kohlerz/SnowMelt/PCBs/mega/mega_pcb.png

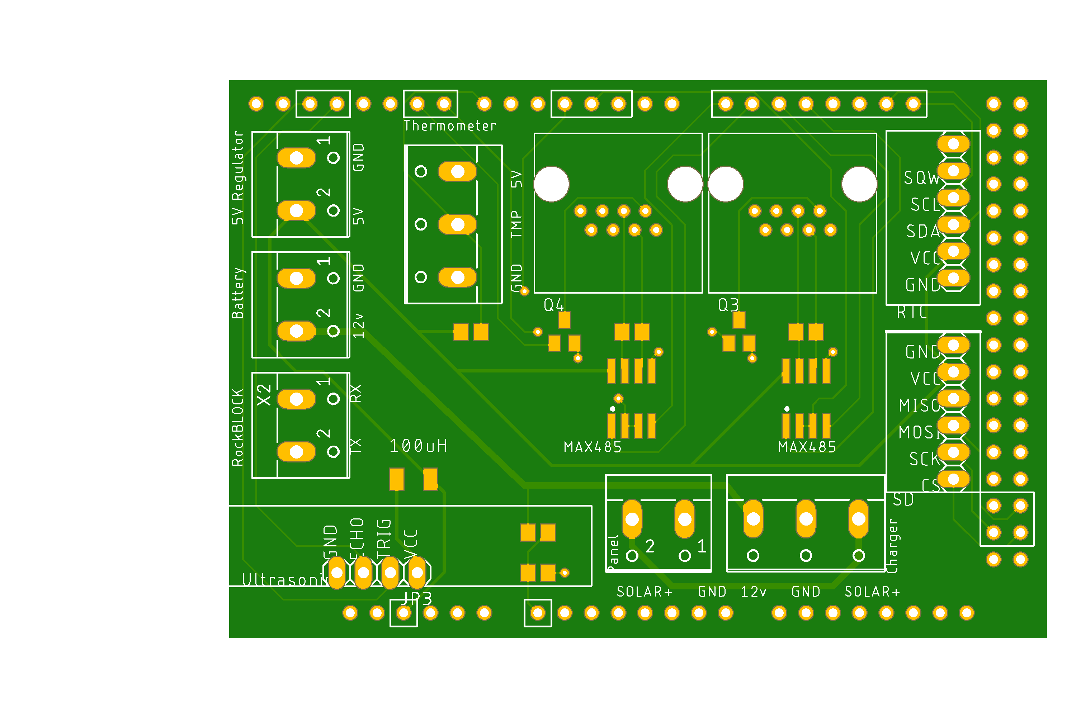
PCBs/mega/mega_pcb.png
