kohlerz/SnowMelt/PCBs/scale/scale_pcb.png

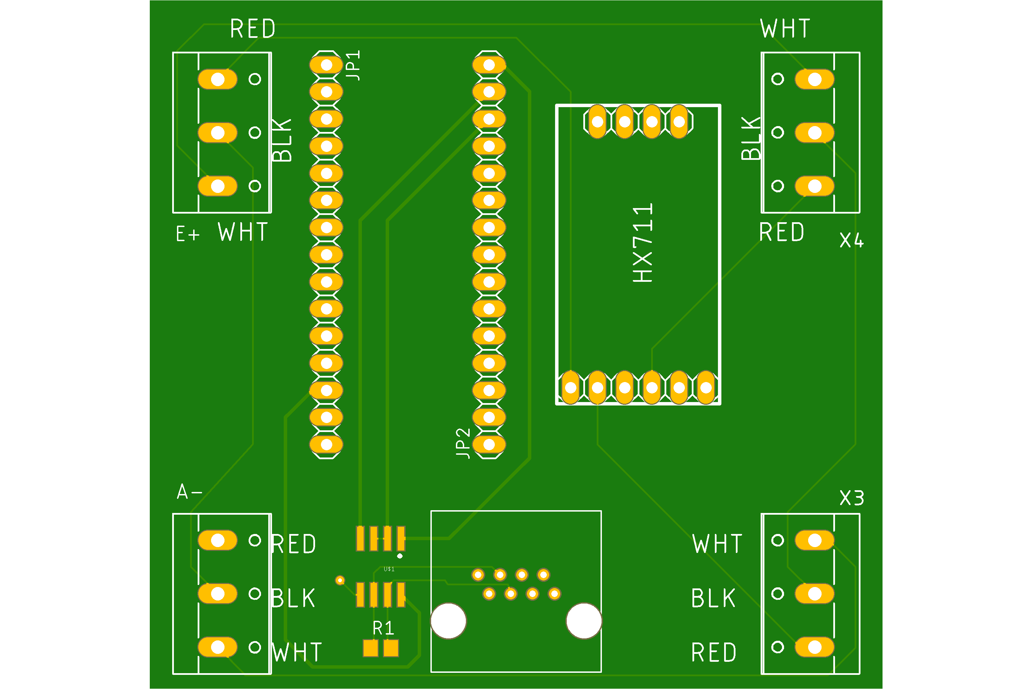
PCBs/scale/scale_pcb.png
