kohlerz/SnowMelt/src/WiFi Mega DIP Settings.jpg

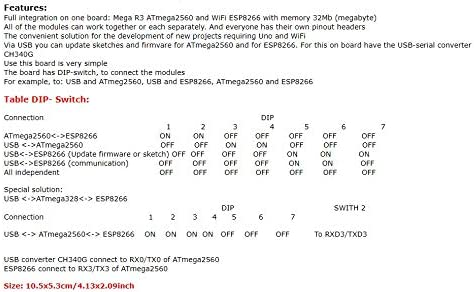
src/WiFi Mega DIP Settings.jpg
