kohlerz/SnowMelt/3D Printing Files/ScaleBottom.stl

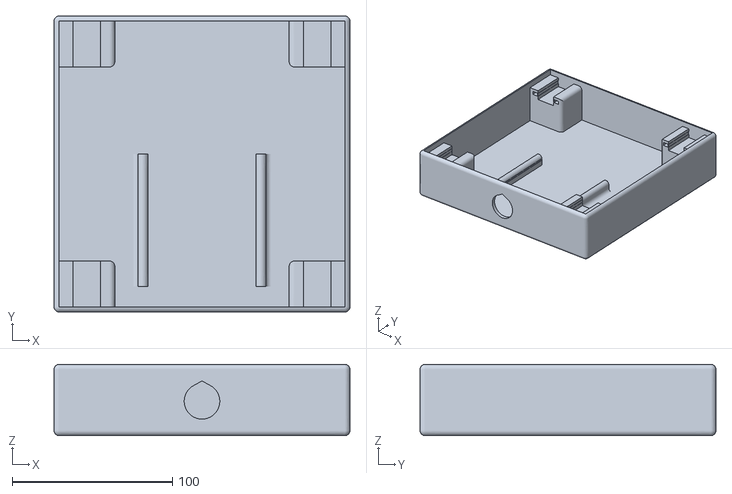
[picture p4: CAD file, 2021-11-07]
3D Printing Files/ScaleBottom.stl
184.8 x 184.8 x 44.4
