kohlerz/SnowMelt/3D Printing Files/ScaleTop.stl

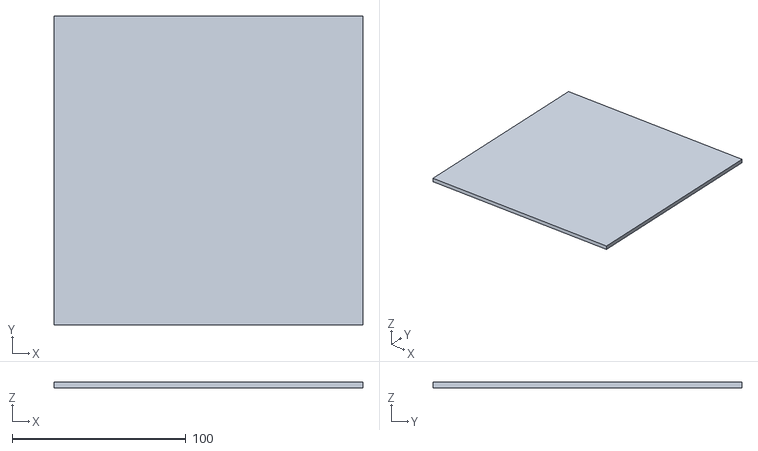
[picture p5: CAD file, 2021-11-07]
3D Printing Files/ScaleTop.stl
177.8 x 177.8 x 3.17
