kohlerz/SnowMelt/PCBs/mega/mega_schematic.pdf

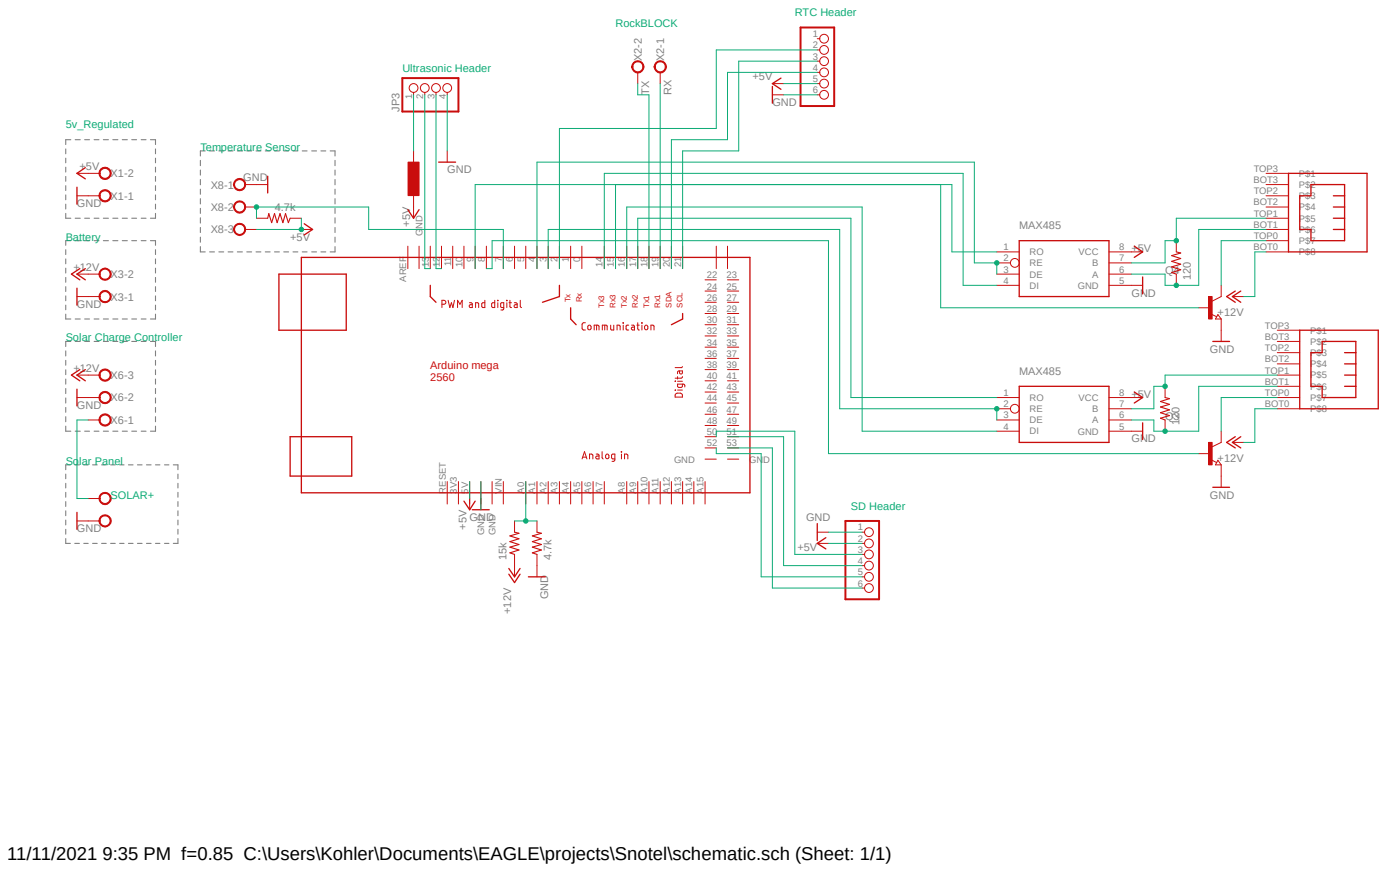
[picture p6: page 1]
MAX485 MAX485; +5V GND; GND; GND GND GND GND +5V; +12V GND; 7 VCC; 8 AREF GND 131211109; 23 25 27 29 31 33 35 37 39 41 43 45 47 49 51 53 GND; 52 GND VIN; A⁰A¹A²A³A⁴A⁵A⁶A⁷; A⁸A⁹A¹⁰ A¹¹ A¹² A¹³ A¹⁴ A¹⁵ GND GND RESET 3V³ 5V; P$1 TOP3; P$2 BOT3; P$3 TOP2; P$4 BOT2; P$5 TOP1; P$6 BOT1; P$7 TOP0; P$8 BOT0; P$8 BOT0 X²⁻²; X²⁻¹ TxRx; Tx3 Rx3 Tx2 Rx2 Tx1 Rx1 SDA SCL; Arduino mega 2560 SOLAR+; 5v_Regulated; Battery; RockBLOCK; Temperature Sensor; Ultrasonic Header; RTC Header; SD Header

Solar Charge Controller Solar Panel
+12V GND GND

11/11/2021 9:35 PM f=0.85 C:\Users\Kohler\Documents\EAGLE\projects\Snotel\schematic.sch (Sheet: 1/1)
