kohlerz/SnowMelt/PCBs/scale/scale_schematic.pdf

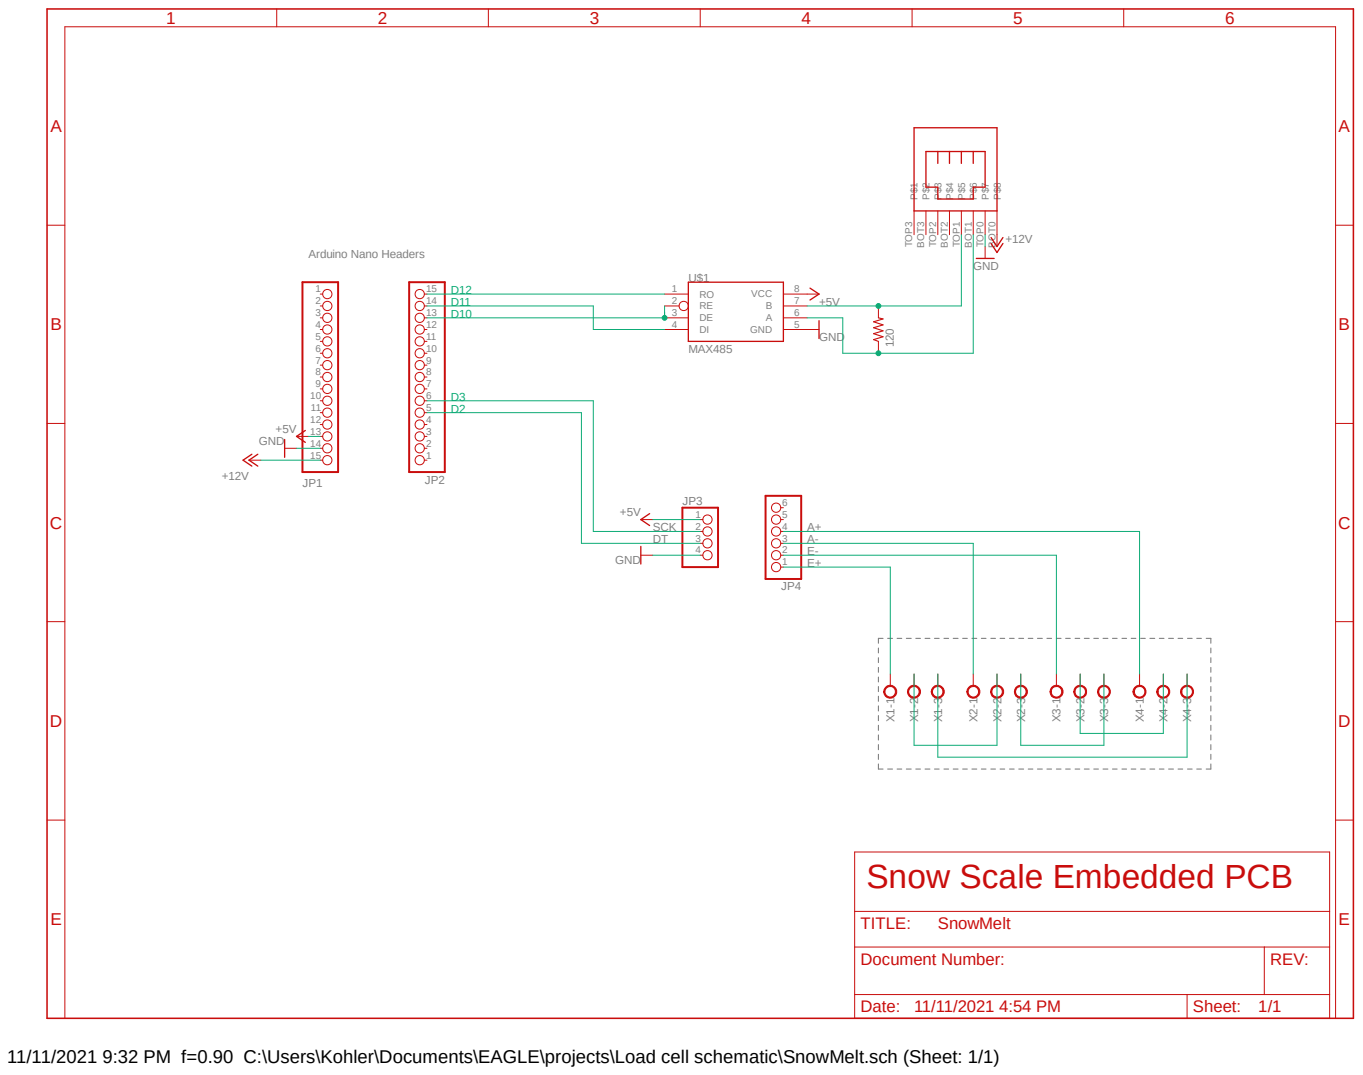
[picture p7: page 1]

Snow Scale Embedded PCB

Document Number: | REV:

Date: 11/11/2021 4:54 PM | Sheet: 1/1

11/11/2021 9:32 PM f=0.90 C:\Users\Kohler\Documents\EAGLE\projects\Load cell schematic\SnowMelt.sch (Sheet: 1/1)
