kohlerz/SnowMelt/PCBs/mega/mega.brd

## EAGLE design PCBs/mega/mega.brd (2021-11-12)

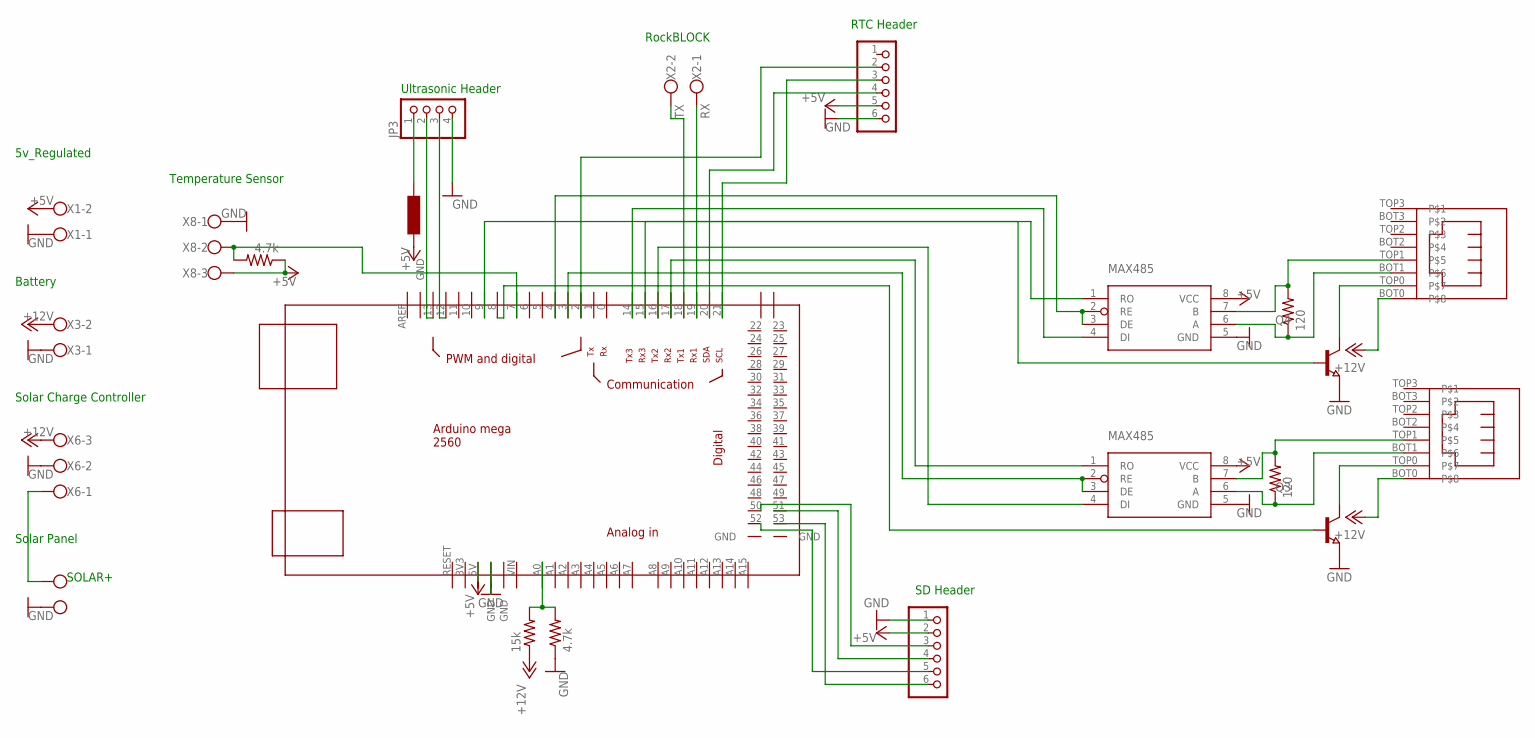
[picture p8: schematic mega.sch]

Parts:
JP1, JP2: PINHD-1X6; 1X06
JP3: PINHD-1X4; 1X04
JP4, JP5: ETHERNET
L1: 100uH; NLFV32T-101K-EF
Q3, Q4: NPN-TRANSISTOR_SOT23; SOT23
R1, R7: 120; R0805
R3, R9: 4.7k; R0805
R8: 15k; R0805
U$1, U$2: MAX485; SO08
U$3: MEGA_DEVICE; MEGAOUTLINE
X1, X2, X3, X7: W237-102
X6, X8: W237-103

Connections:
+5V: JP1.2, JP2.5, L1.P$1, R3.1, U$1.8 (VCC), U$2.8 (VCC), U$3.5V, X1.2, X8.3
+12V: JP4.BOT0, JP5.BOT0, R8.1, X3.2, X6.3
GND: JP1.1, JP2.6, JP3.4, Q3.2 (E), Q4.2 (E), R9.1, U$1.5 (GND), U$2.5 (GND), U$3.GND@2 (GND), X1.1, X3.1, X6.2, X7.1, X8.1
unnamed: JP4.TOP1, R1.2, U$1.7 (B)
unnamed: JP4.BOT1, R1.1, U$1.6 (A)
unnamed: JP5.TOP1, R7.2, U$2.7 (B)
unnamed: JP5.BOT1, R7.1, U$2.6 (A)
unnamed: U$2.1 (RO), U$3.17
unnamed: U$2.4 (DI), U$3.16
unnamed: U$1.1 (RO), U$3.15
unnamed: U$1.4 (DI), U$3.14
unnamed: JP2.2, U$3.2
unnamed: U$2.2 (RE), U$2.3 (DE), U$3.3
unnamed: U$1.2 (RE), U$1.3 (DE), U$3.4
unnamed: JP2.3, U$3.21
unnamed: JP2.4, U$3.20
unnamed: JP1.6, U$3.53
unnamed: JP1.5, U$3.52
unnamed: JP1.4, U$3.51
unnamed: JP1.3, U$3.50
unnamed: JP3.2, U$3.13
unnamed: JP3.3, U$3.12
unnamed: Q3.1 (B), U$3.8
unnamed: JP4.TOP0, Q4.3 (C)
unnamed: JP5.TOP0, Q3.3 (C)
unnamed: Q4.1 (B), U$3.9
unnamed: JP3.1, L1.P$2
unnamed: R8.2, R9.2, U$3.A0
unnamed: X6.1, X7.2
unnamed: R3.2, U$3.7, X8.2
RX: U$3.19, X2.1
TX: U$3.18, X2.2

Notes on the sheet:
SOLAR+
5v_Regulated
Battery
Solar Charge Controller
Solar Panel
RockBLOCK
Temperature Sensor
Ultrasonic Header
RTC Header
SD Header

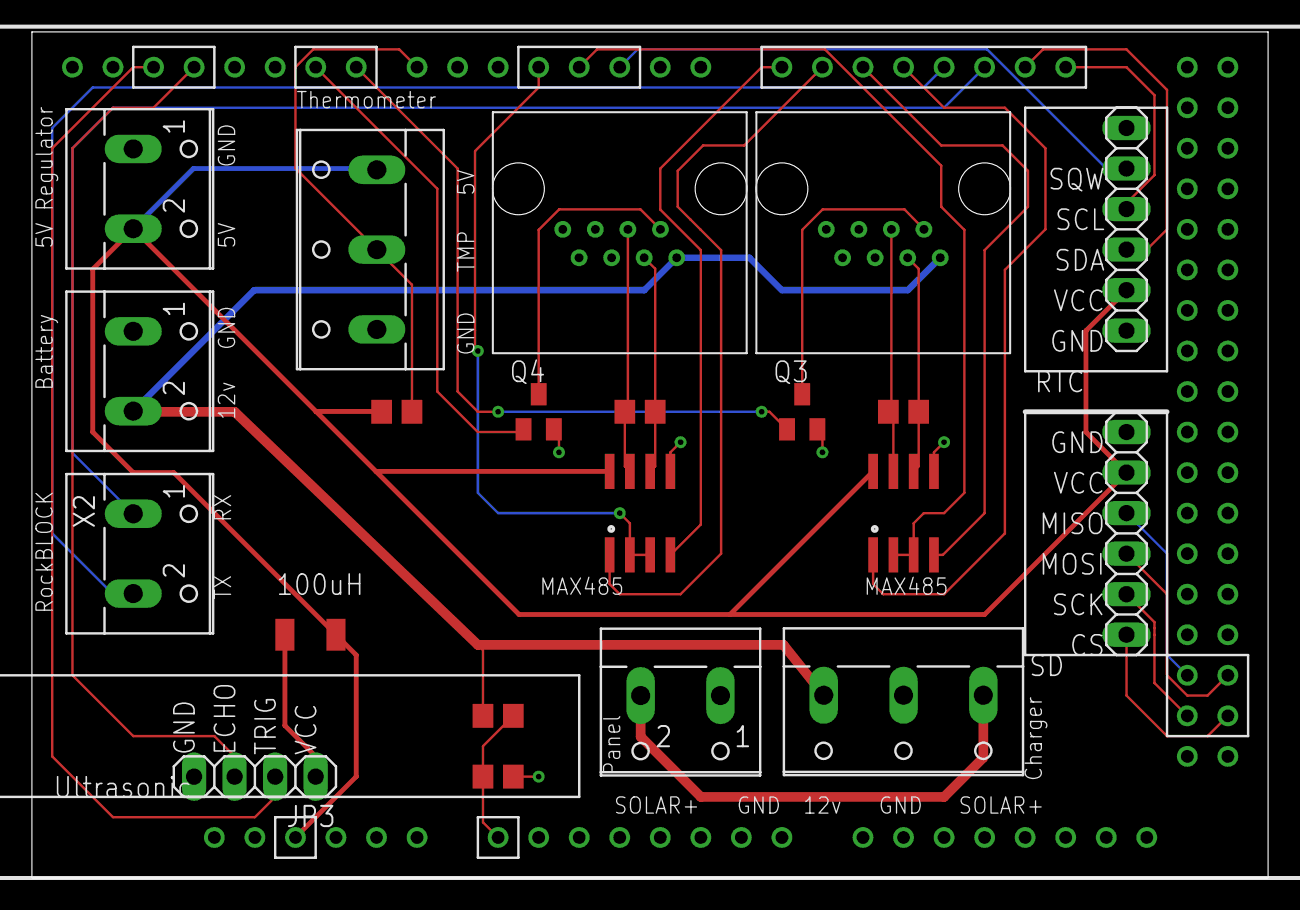
[picture p9: board mega.brd from above]

Board: 2 copper layers, 77.5 x 53.0 mm, 22 parts (0 on the bottom side), 32 nets.
