kohlerz/SnowMelt/(commit log)

2021-08-06 Using ArduinoJson Library
2021-08-17 Upload Scale STL Files
    [ScaleBottom.stl, ScaleTop.stl]
2021-08-28 Embedded code on prototype
    This code runs on the first SNOTEL device
2021-11-07 Shrunk scales to fit inside bags
    [ScaleBottom.stl, ScaleTop.stl]
2021-11-12 Added PCB information and organized all the files
    [ScaleBottom.stl, ScaleTop.stl, mega.brd, mega.sch, mega_assembly.csv, mega_bom.csv, scale.brd, scale.sch]
